juanboro/cheap-esphome-lg-control/README.md

# cheap-esphome-lg-control

This repository documents two low-cost DIY ways to create an interface for [esphome-lg-controller](https://github.com/JanM321/esphome-lg-controller).

## UART <-> LIN Adapter
The first method is to use a low-cost TTL UART to LIN transciever adapter.  These can be bought on Amazon or Aliexpress from various sellers.  I obtained mine on sale for $1 including shipping.

Materials needed:
* ESP32 board (any variant should do - easily obtained from Amazon or Aliexpress)
* 3.3V TTL UART LIN adapter
* Female Dupont wires/connectors (or 3 pin female JST-XH if available).
* Optional: other sensors/etc to hook to ESP32 (i.e: [low cost temperature-humidity sensor](https://esphome.io/components/sensor/dht/))
* Optional: Voltage regulator board (i.e: [these](https://www.amazon.com/dp/B0FDB25T5L))

The challenge with using the adapter is because of the slow baud rate, the LIN bus adapter will time out when the transmit line is held low too long.  I have documented how this can be worked around [here](doc/Low_baud_linxcvr_workaround.md).

To make this work with the ESPHome LG controller - just customize the following yaml file: [esp32_example_uart_lin_xcvr.yaml](esphome/esp32_example_uart_lin_xcvr.yaml) to your own setup.

My basic working example setup before placing in project junction box is pictured [here](doc/images/lg_hvac_lin_xcvr_working.jpg)

### Notes
* To create the glitches on the UART TX line to the LIN transceiver - this uses ESP32 remote_receiver to obtain the signals from the UART, and then it adds the glitches as necessary and retransmits using the remote transmitter.  Because of the very slow bit rate, the pulses are very long - which requires decreasing the clock resolution (divider) used by the remote hardware (and maybe the UART hardware?).  This seems to have un-documented impacts on the timing from the UART - the pulses and timings are still *close* enough - but they definetly are impacted by the clock resolution adjustment.  With the current settings I have in the yaml file - everything seems to work on my ESP32 and *should* work on all other variants - but let me know if it doesn't.
* A future enhancement I may do would be to just bit-bang the output directly to the GPIO via the interval component and not use the TX UART and remote hardware.  The timing for the interface is so slow it really would not impact any other things running on the board with ESPHome.

## Discrete LG controller level-shift interface
* A simple interface can be built using a 10k resistor and 2 n-mosfets [2N7000](https://ww1.microchip.com/downloads/en/DeviceDoc/2N7000-N-Channel-Enhancement-Mode-Vertical-DMOS-FET-Data-Sheet-20005695A.pdf) *should* work assuming the Vth of them is <=3.3V.
* I have tested this with my LG dual inverter unit directly and it works.  I also have tested it with the LIN-Transceiver as documented [here](doc/Low_baud_linxcvr_workaround.md).
* To use with ESPHome - you should be able to just customize the following yaml file: [esp32_example_uart_lvlshift_lg.yaml](esphome/esp32_example_uart_lvlshift_lg.yaml)
* Here is the schematic:
<table>
  <tr>
    <td valign="top">Schematic</td>
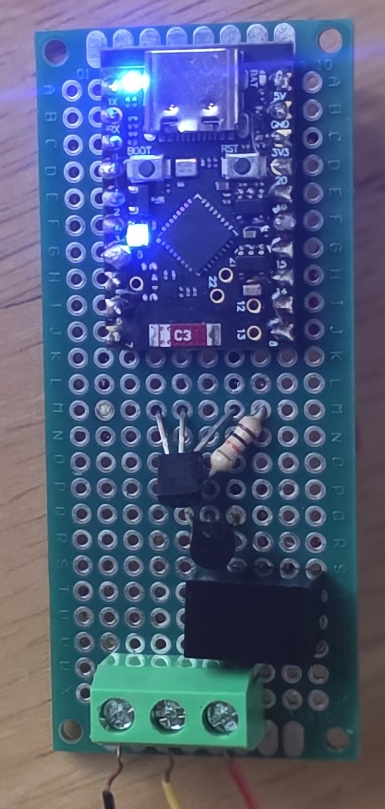
[picture p1: doc/images/LG PCB Board.jpeg]
PCB
    <td valign="top"></td>
  </tr>
</table>

### Notes:
* Caution: If you are uploading code to the ESP-32 board via the on board USB - do not attach the LG-controller at the same time via the TSR regulator.
* You potentially can use a better logic level mosfet with lower threshold voltage.  For non-SMT - there are some options available although many of them have fairly high drive - so much bigger gates with higher gate capacitance - which means you should connect a resistor in series between the gpio and the gate of the fet.  [IRLZ34](https://www.vishay.com/en/product/91327/) works quite well with a 1k resistor in series to the gate.
* For this setup with ESPHome - the ESP32 UART RX and TX are inverted from how a TTL UART normally is operated because of the logic level shift from the mosfets.
* Example of my working config including with color LED status light: [esp32c6_example_lvlshift.yaml](esphome/esp32c6_example_lvlshift.yaml)

### Suggested BOM
* Perfboard and solder
* Microcontroller: ESP32C6 super mini dev board
* Voltage Regulator: Traco (TSR1-2433)[https://www.tracopower.com/sites/default/files/products/datasheets/tsr1_datasheet.pdf?t=1793318401] or similar fully integrated regulator - pin1 (Vin) has the dot on it.
* 1 10k resistor
* 2 [2N7000](https://ww1.microchip.com/downloads/en/DeviceDoc/2N7000-N-Channel-Enhancement-Mode-Vertical-DMOS-FET-Data-Sheet-20005695A.pdf) mosfets - pin1=source=ground
* 1 3-pin screw terminal
* 1 3-pin female JST-XH connector

## Other Notes and Observations
### LG mini-split units and CN-REMO socket
* *always* switch off the electric supply to your unit before attempting to access the plug.
* With any luck - CN_REMO is easy to access.  On my dual inverter wall unit - all that is necessary is [removing](https://www.youtube.com/watch?v=Yl4yhYUb_Fg&t=20s) the tabbed bottom panel (no screws).  There is a 3 pin green extender connector already coming out of the control box.
 It is easier to see/find if you remove the top cover.  If you have small fingers and are coordinated - you might not need to remove the top - after doing multiple units - I'd recommend removing the top.
* My floor wall unit was a little less easy.  It required removing the the control unit and cover from the control unit to directly access the PCB and manually add an extension cable from the CN_REMO socket on the control board.

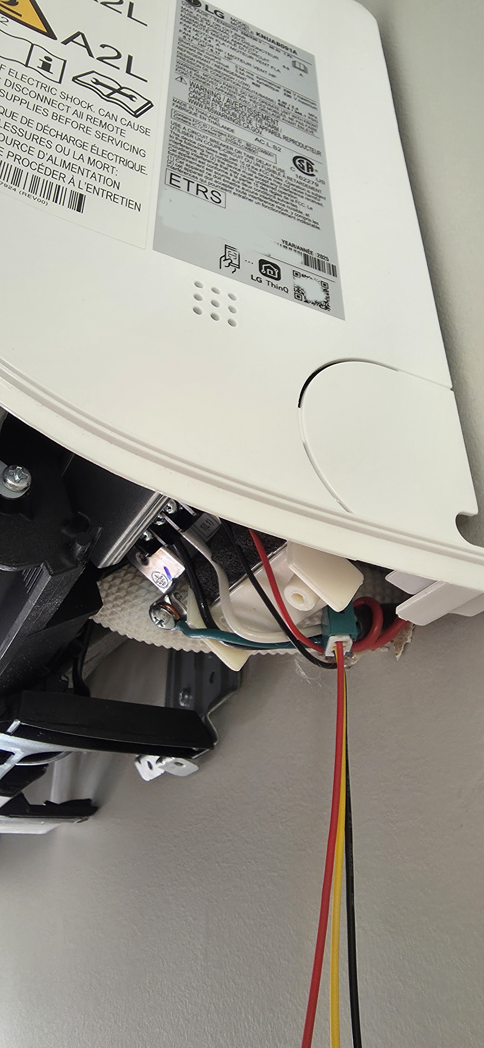
[picture p2: doc/images/cn_remo_dual_inverter_unit.jpeg]
cn_remove_dual_inverter
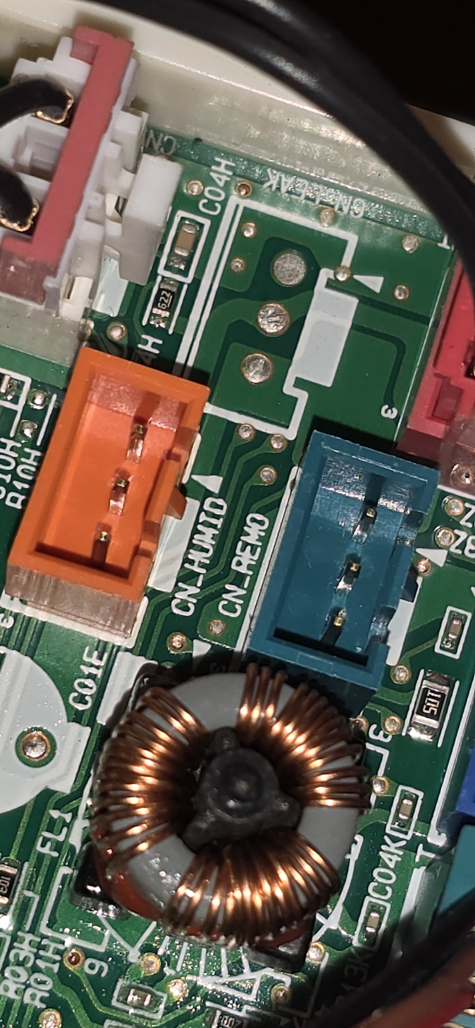
[picture p3: doc/images/cn_remo_on_board.jpg]
cn_remo_board


### ESP8266 and LG controller
Can an ESP8266 be used?  Answer: No (at least without major difficulty).
* The hardware UART won't support the 104 baud rate [src](https://docs.espressif.com/projects/esp-faq/en/latest/software-framework/peripherals/uart.html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)
* The ESPHOME software UART stops interrupts on transmit so the loopback read happening at the same time will not be seen.

### Be careful - no warranties
* Use this information at your own risk. I am not responsible for any damage, injury, or loss caused by using these instructions or designs.
