juanboro/cheap-esphome-lg-control/doc/images/lg_hvac_lin_xcvr_working.jpg

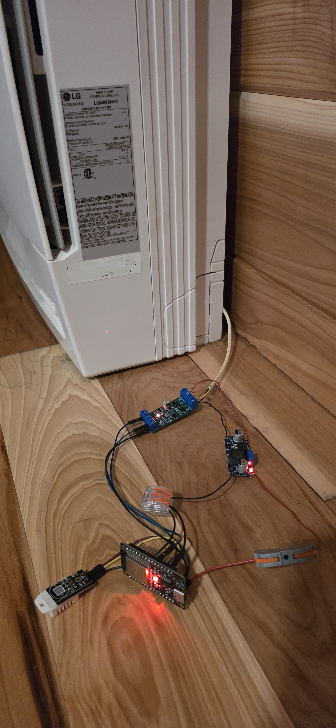
doc/images/lg_hvac_lin_xcvr_working.jpg
