juanboro/cheap-esphome-lg-control/doc/kicad/lg_interface.kicad_sch

## KiCad design doc/kicad/lg_interface.kicad_sch (2026-10-30)

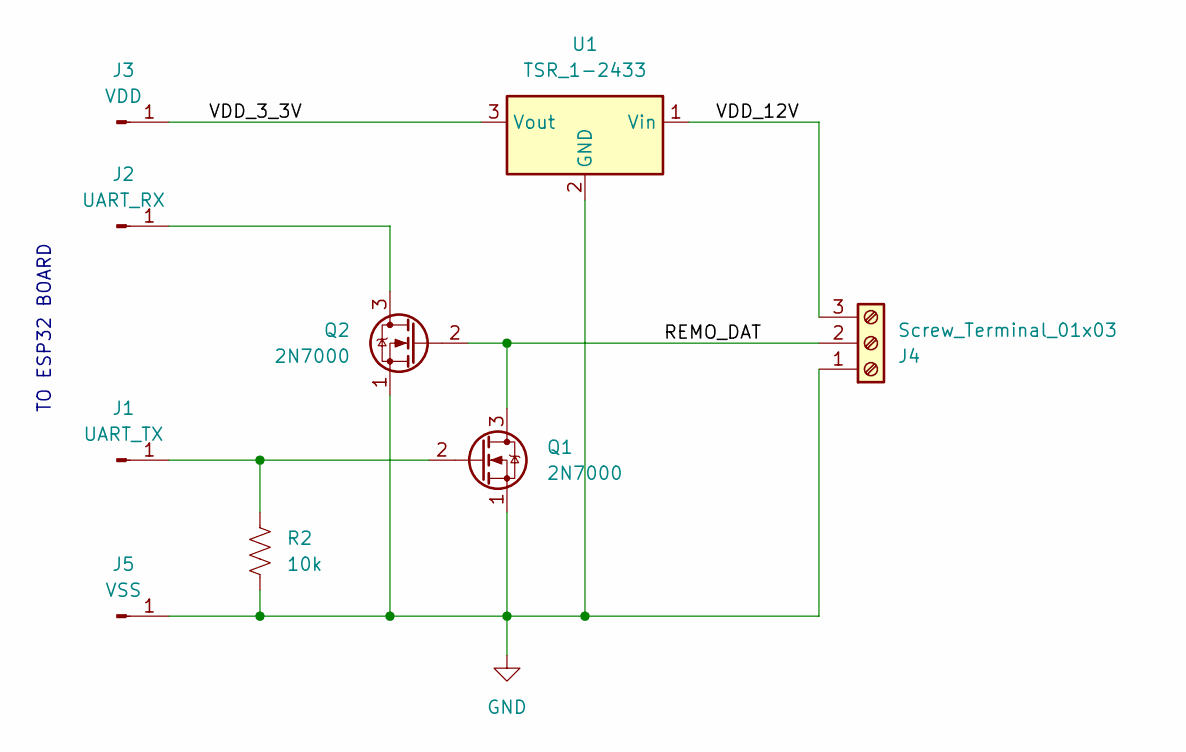
[picture p7: schematic lg_interface.kicad_sch]

Parts:
J1: UART_TX
J2: UART_RX
J3: VDD
J4: Screw_Terminal_01x03
J5: VSS
Q1, Q2: 2N7000; TO-92_Inline
R2: 10k
U1: TSR_1-2433; Converter_DCDC_TRACO_TSR-1_THT

Connections:
GND: J4.1, J5.1, Q1.1 (S), Q2.1 (S), R2.2, U1.2 (GND)
unnamed: J1.1, Q1.2 (G), R2.1
unnamed: J2.1, Q2.3 (D)
REMO_DAT: J4.2, Q1.3 (D), Q2.2 (G)
VDD_3_3V: J3.1, U1.3 (Vout)
VDD_12V: J4.3, U1.1 (Vin)

Notes on the sheet:
TO ESP32 BOARD
