juanboro/cheap-esphome-lg-control/(commit log)

2026-08-11 add template controller yaml
    [lg_controller.yaml]
2026-08-12 add initial schematic
2026-08-12 add another example yaml file
    [lg_controller.yaml]
2026-08-21 Document ESP8266 UART limitations and observations
    Added observations regarding the ESP8266 and its limitations with UART.
2026-08-21 Update README with detailed component specifications
    Clarified requirements and notes regarding components and setup for ESP32 and ESP8266.
2026-09-20 add board
2026-10-30 update schematic
2026-10-30 Update suggested BOM with detailed component links and pin information
2026-10-30 Update svg export. Add kicad schematic
